jFoster426/Capstone/Invoices/README.txt

CA21G062DACII.pdf
Amazon
- Copper Shielding Foil
Total: $27.32

87327651.pdf
Digi-Key
- Parts for PoC
Total: $135.08

88081512.pdf
Digi-Key
- Parts for Main Board Prototype 1
Total: $209.14

88237087.pdf
Digi-Key
- Microcontrollers (ESP32S3 and DevKit)
- Load Cell Amplifier
Total: $76.77

88622169.pdf
Digi-Key
- Load Cells
Total: $56.75

89655280.pdf
Digi-Key
- Shin Strap Prototype 1 Parts
- Omit: SFURS Components, Ritesh's Components
        4.87 + 0.45 + 7.79 + 3.32 + 12.95 + 2.59 + 2.59 + 0.46 + 0.22
      + 0.54 + 6.43 + 0.22 + 0.18 + 0.40 + 0.22 + 0.37 + 0.54 + 0.54
      + 4.27 + 39.53 + 1.09 + 2.46 + 1.35 + 3.36 + 6.99 + 3.30
- Omit Total: $107.03
Total: 218.33 - (107.03 * 1.12) = $98.46

90552447.pdf
Digi-Key
- Main Board Parts
Total: $197.43

2039395A202203161013858.pdf
JLCPCB
- Main Board PCB Prototype 1
Total: $35.89
Total Charged to Credit Card: $37.11

2039395A202206251404717.pdf
JLCPCB
- Main Board PCB Prototype 2
Total: $76.41
Total Charged to Credit Card: $78.54

2039395A202206271223129.pdf
JLCPCB
- LCD PCB
- Load Cell PCB
- Omit: Ritesh's PCB ($5.19)
Total: 40.97 - 5.19 = $35.78
Total Charged to Credit Card: 42.11 - (5.19 * 1.0278) = $36.78

2039395A202205171115238.pdf
JLCPCB
- Shin Strap PCB Prototype 1
Total: $34.40
Total Charged to Credit Card: $35.67

------------------ Total ------------------

27.32 + 135.08 + 209.14 + 76.77 + 56.75 + 98.46 + 197.43 + 37.11 + 78.54 + 36.78 + 35.67

= 989.05
