jFoster426/Capstone/Misc/ISCP Pinout Beta Boards.docx

Main Board

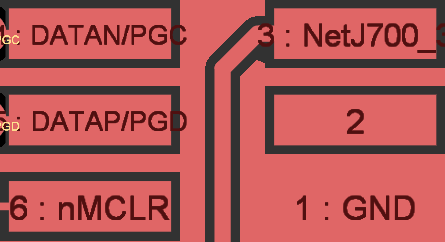
[picture p1: figure]

Shin Strap

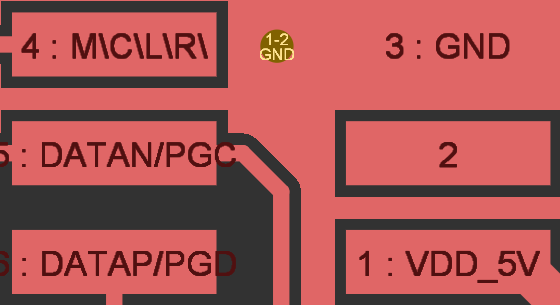
[picture p2: figure]
