jFoster426/Capstone/Lunch and Learn Presentations/Presentation1.pptx

STRASTech
Electronics Overview
Proof-of-Concept Prototype

## Slide 2

Electronics

Host Computer

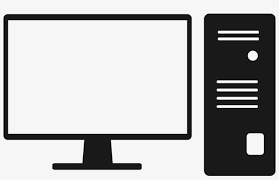
[picture p3: figure]
Free Pc Clipart, Download Free Pc Clipart png images, Free ClipArts on Clipart Library
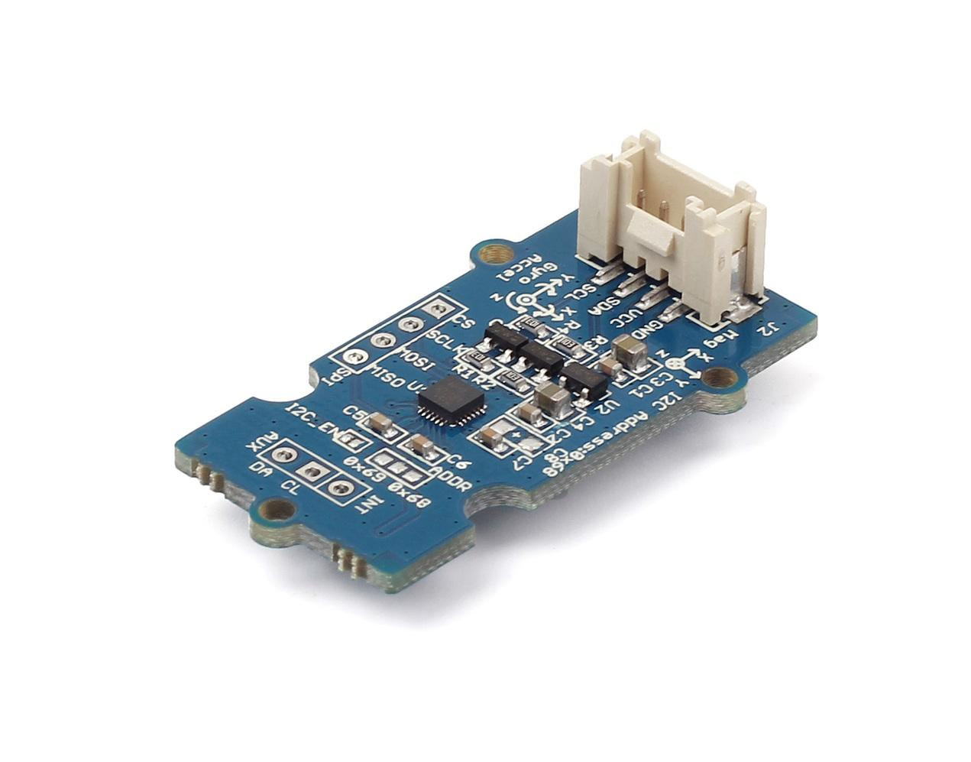
[picture p4: figure]
Grove - IMU 9DOF v2.0 - Seeed Wiki

9 Axis IMU (x2)

Start/Stop LED

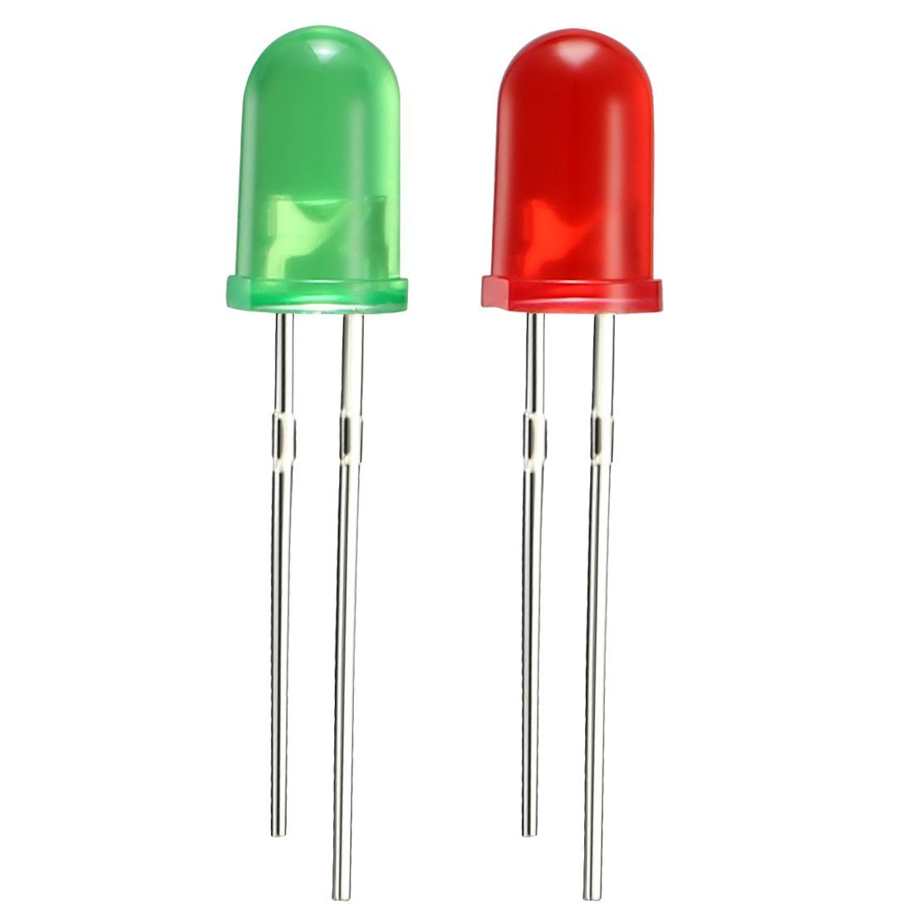
[picture p5: figure]
uxcell 16pcs 2 Colors x 8pcs 5mm Red Green LED Diode Lights Colored Lens Diffused Round 20mA Lighting Bulb Lamp Electronic Components Light Emitting Diodes: Amazon.com: Industrial & Scientific
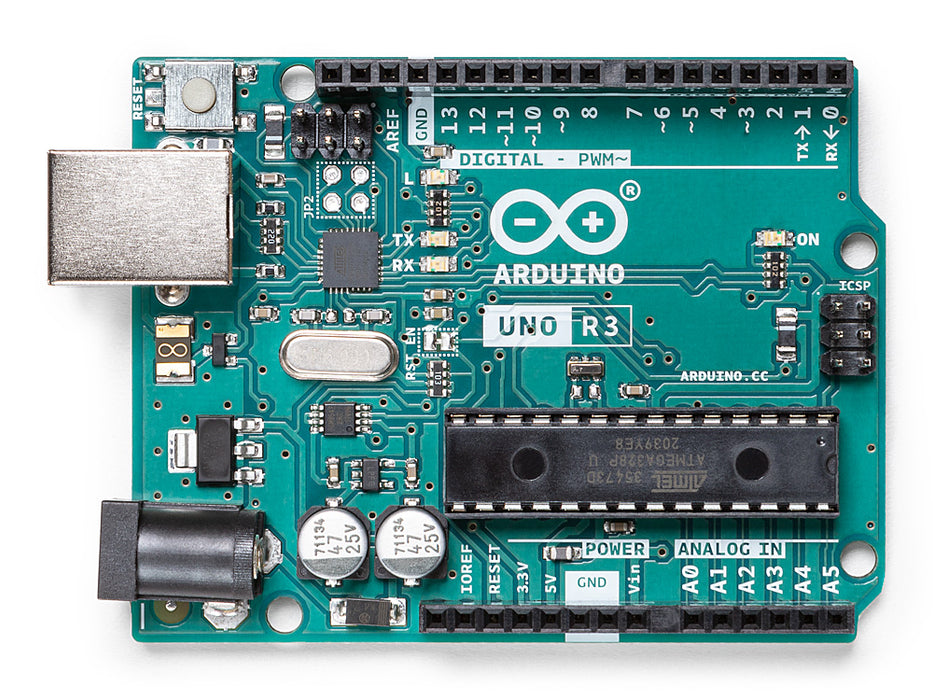
[picture p6: figure]
Arduino Uno Rev3 — Arduino Official Store

Arduino UNO

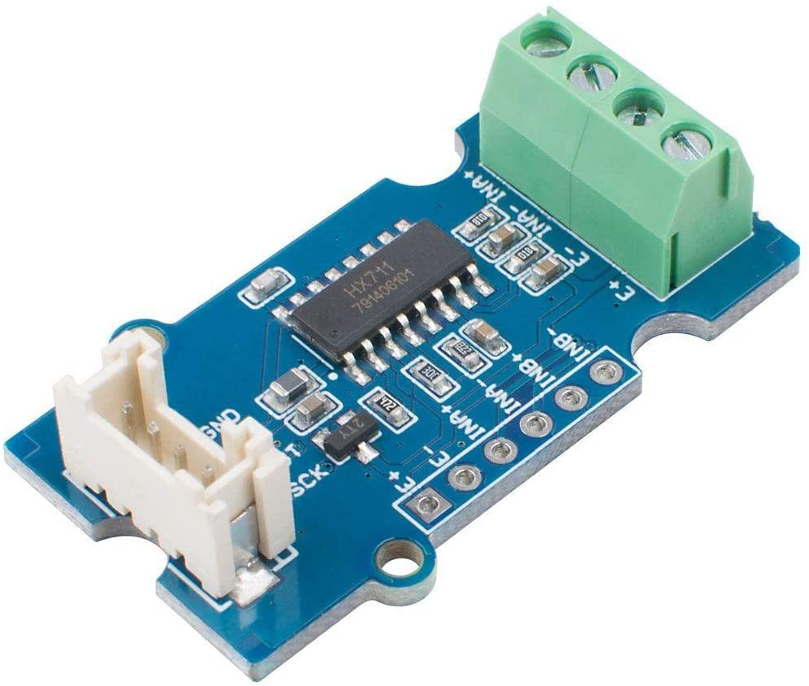
[picture p7: figure]
Seeed Grove - ADC for Load Cell: Amazon.de: Computer & Accessories

HX711 Load Cell Amp

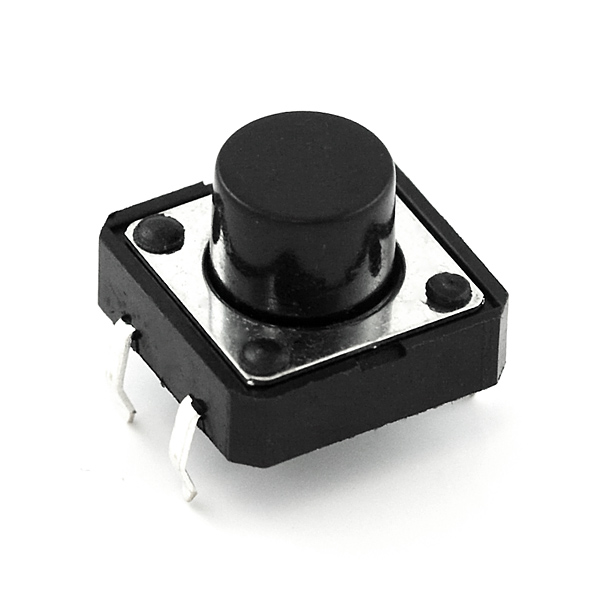
[picture p8: figure]
Momentary Pushbutton Switch - 12mm Square - COM-09190 - SparkFun Electronics

Start/Stop Button

## Slide 3

Electronics – Load Cell

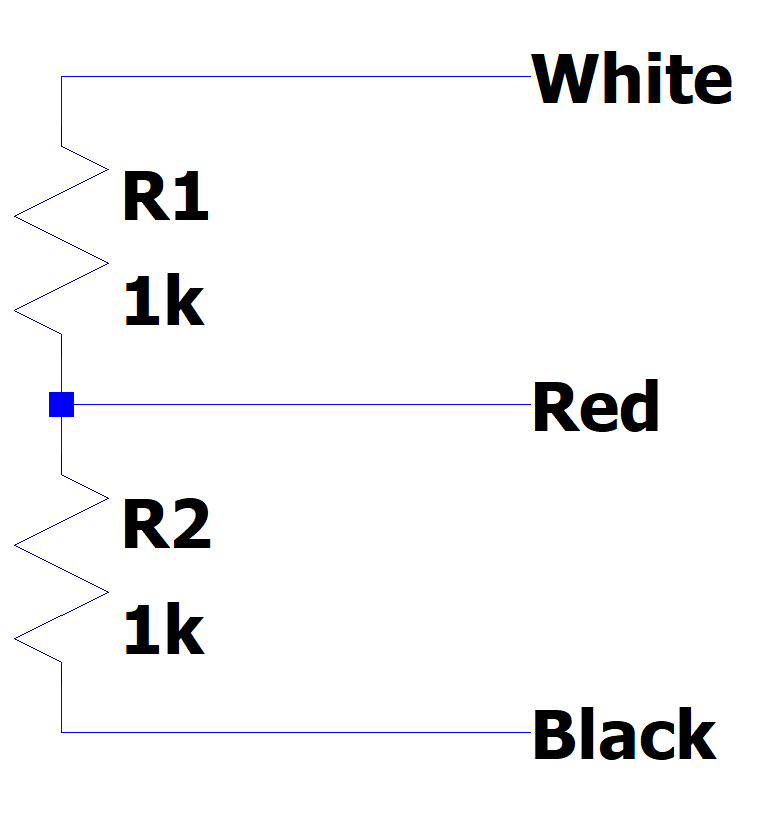
[picture p9: figure]

## Slide 4

Electronics – Load Cell Bridge

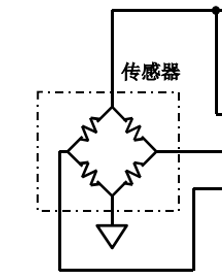
[picture p10: figure]

Load Cell #1

Load Cell #2

5V

Load Cell Amplifier

## Slide 5

Electronics – HX711

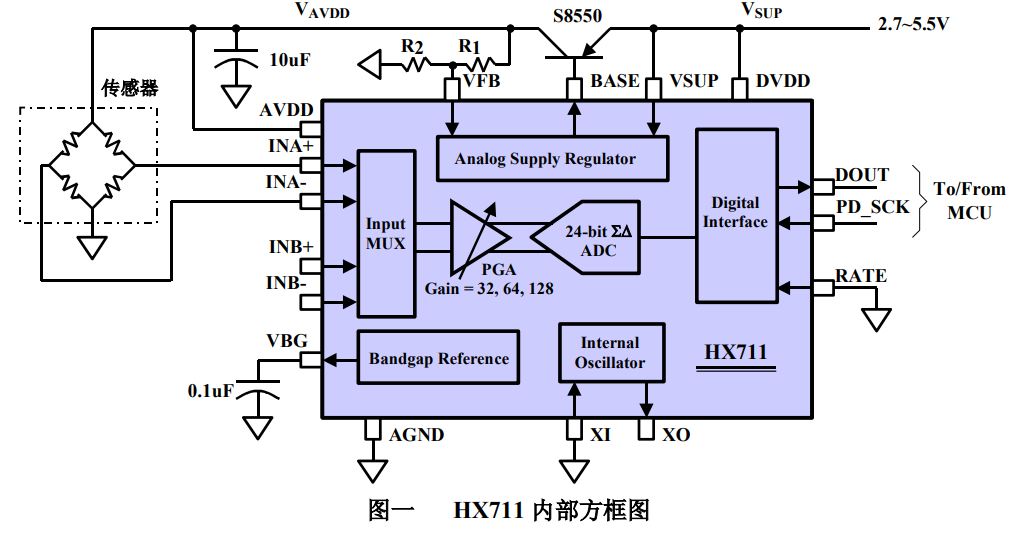
[picture p11: figure]

RATE=1, 80 Samples/s
RATE=0, 10 Samples/s

## Slide 6

Communicate to Arduino over I2C, allows both shin and foot IMU to use the same bus, with different addresses.

Electronics – IMU

Accelerometer

- Measure acceleration due to gravity when stationary
- Measure translational acceleration during motion
- How can we differentiate the two?

Gyroscope

- Measure angular (not translational) velocity
- Suffers from drift (reading a constant value even when still)

Arduino

SCL

SDA

Foot IMU

Shin IMU

Other Stuff (Future)

## Slide 7

Electronics – Firmware

Entry

Init Foot/Shin IMU

Red LED On

Button Pressed?

Green LED On

Button Pressed?

Get one frame of data, send to PC

## Slide 8

Electronics – Data Format

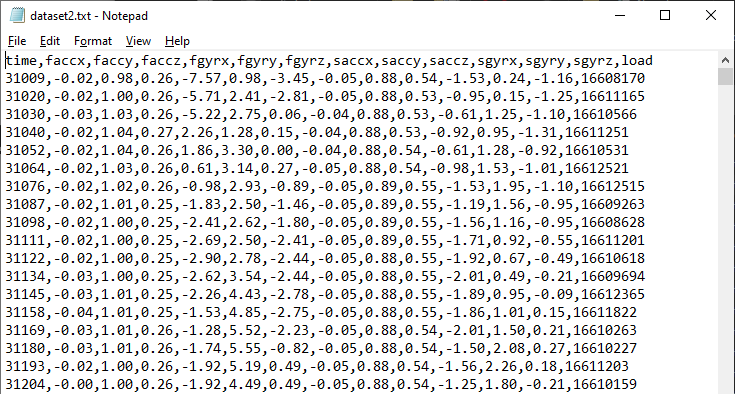
[picture p12: figure]

## Slide 9

Software – Overview

STRASAnkle.exe

Serial Port to .CSV

Filename.txt

Dataset_yyyy_mm_dd_hh_mm_ss.txt

MATLAB

USB

#1

#2

## Slide 10

Software – Joint Angle Algorithm

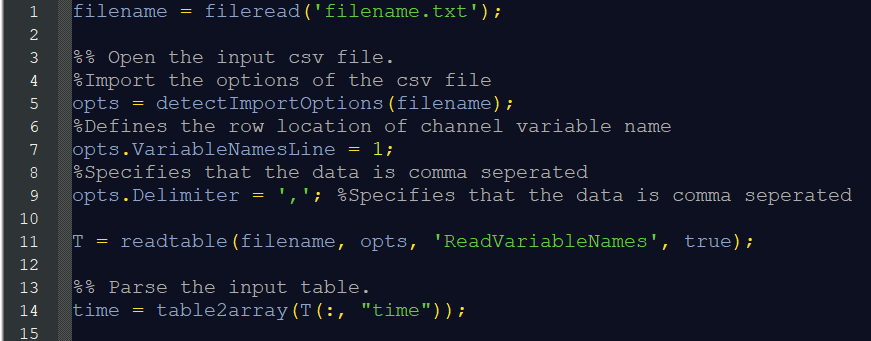
[picture p13: figure]

## Slide 11

Software – Joint Angle Algorithm

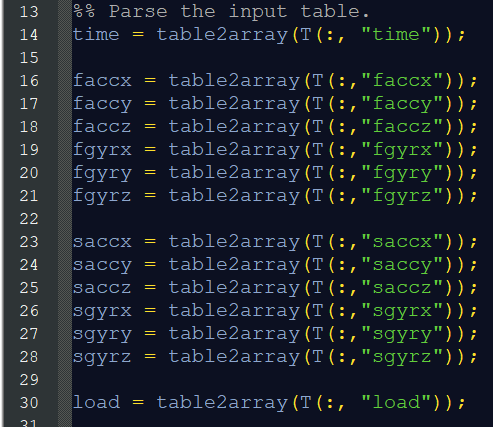
[picture p14: figure]

## Slide 12

Software – Joint Angle Algorithm

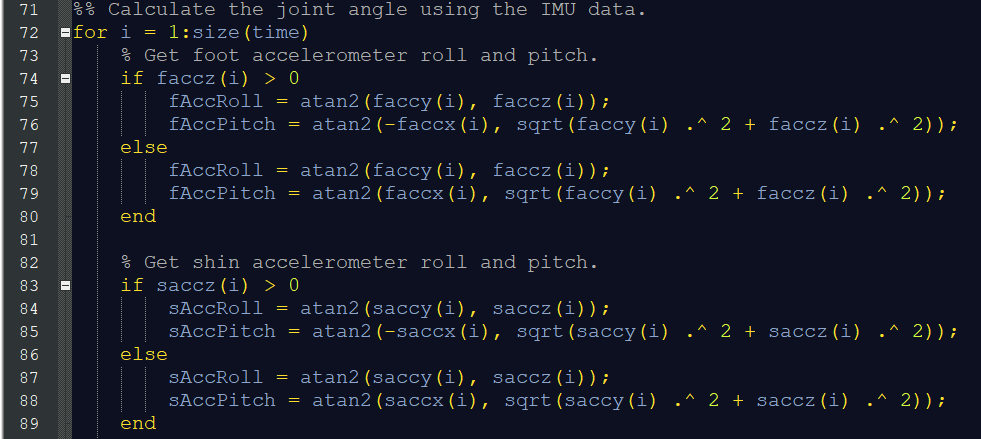
[picture p15: figure]

## Slide 13

Software – Joint Angle Algorithm

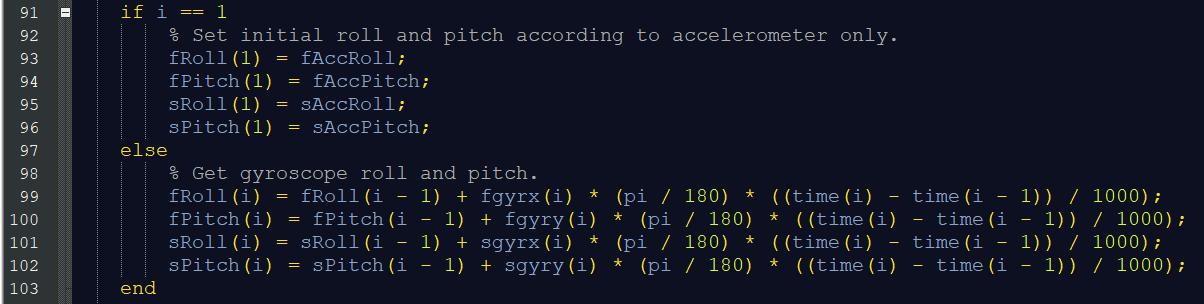
[picture p16: figure]

## Slide 14

Software – Joint Angle Algorithm

## Slide 15

Software – Angular Velocity Algorithm
