jFoster426/Capstone/Caterpillar/Solid Models/Magnet and Dowel 1.SLDASM

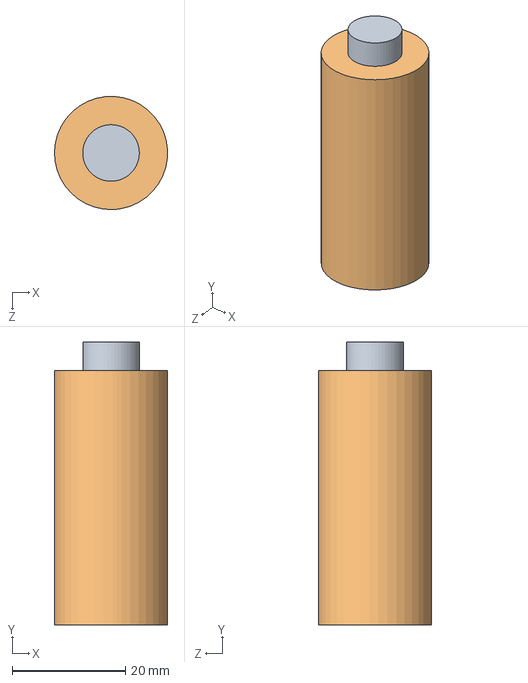
[picture p17: CAD file, 2022-11-08]
Caterpillar/Solid Models/Magnet and Dowel 1.SLDASM
20.0 x 50.0 x 20.0 mm
Magnet 1
Dowel 1
