jFoster426/Capstone/Caterpillar/Solid Models/Assem1.STEP

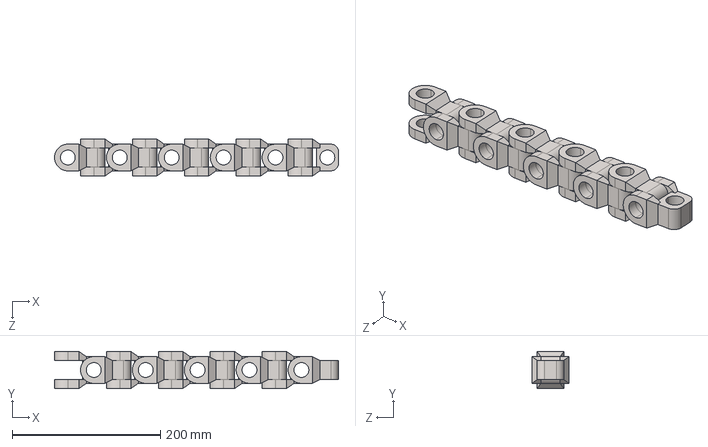
[picture p18: CAD file, 2022-11-08]
Caterpillar/Solid Models/Assem1.STEP
383.0 x 50.0 x 50.0 mm
Joint 1 x 10
