jFoster426/Capstone/Caterpillar/Solid Models/Dowel 1.SLDPRT

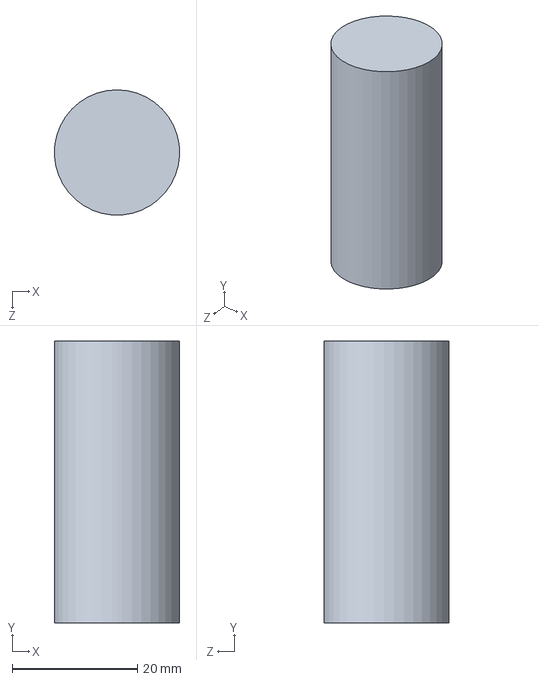
[picture p19: CAD file, 2022-11-08]
Caterpillar/Solid Models/Dowel 1.SLDPRT
20.0 x 45.0 x 20.0 mm
