jFoster426/Capstone/Caterpillar/Solid Models/PCB 1.SLDPRT

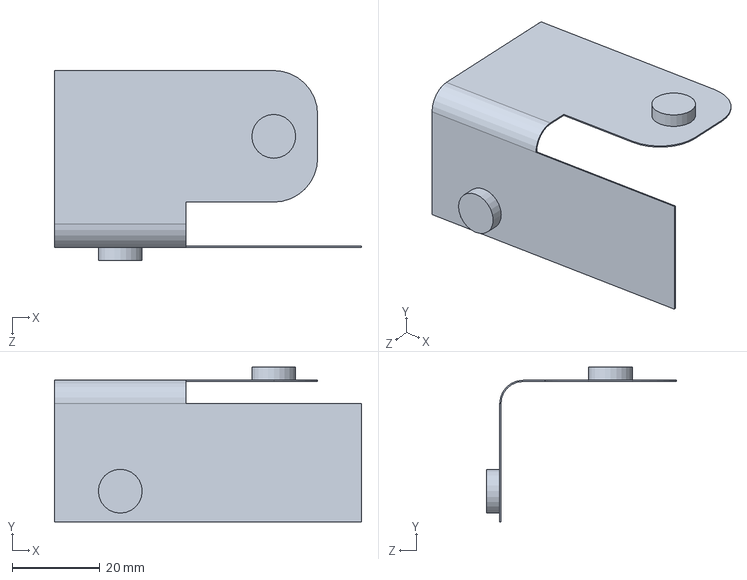
[picture p20: CAD file, 2022-11-08]
Caterpillar/Solid Models/PCB 1.SLDPRT
70.0 x 35.3 x 43.3 mm
