jFoster426/Capstone/Caterpillar/Solid Models/Magnet 1.SLDPRT

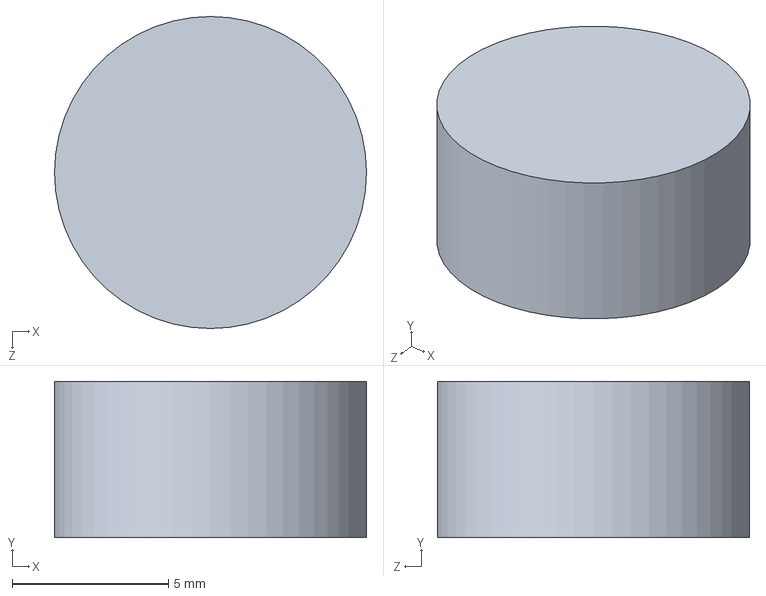
[picture p21: CAD file, 2022-11-08]
Caterpillar/Solid Models/Magnet 1.SLDPRT
10.0 x 5.00 x 10.0 mm
