jFoster426/Capstone/Caterpillar/Solid Models/Joint 1.SLDPRT

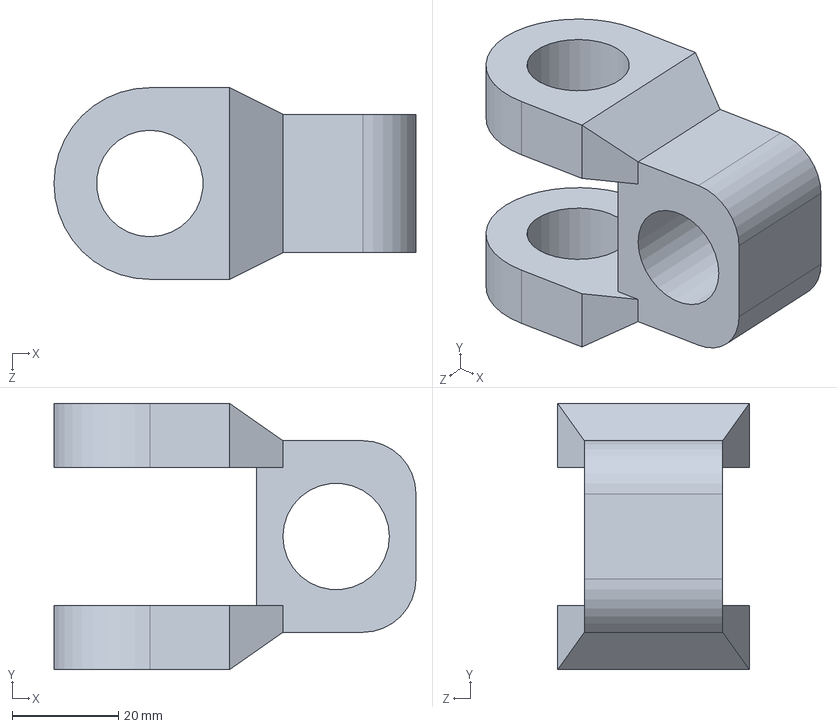
[picture p22: CAD file, 2022-11-08]
Caterpillar/Solid Models/Joint 1.SLDPRT
68.0 x 50.0 x 36.0 mm
