jFoster426/Capstone/(list of files, cad)

Other CAD files:
Caterpillar/Solid Models/Assem1.SLDASM
