jFoster426/Capstone/Misc/Main Board Rough Schematic.pdf

# Inertial Measurement and RTC

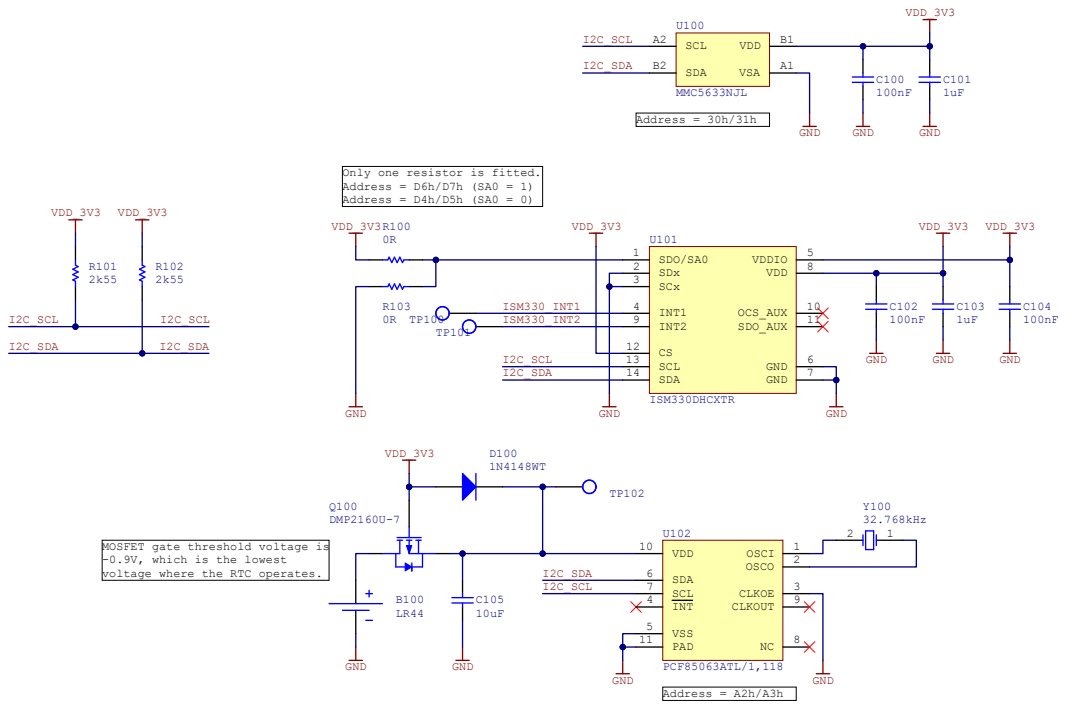
[picture p23: page 1]

Only one resistor is fitted.
Address = D6h/D7h (SA0 = 1)
Address = D4h/D5h (SA0 = 0)

MOSFET gate threshold voltage is
-0.9V, which is the lowest
voltage where the RTC operates.

# Load Cell Acquisition

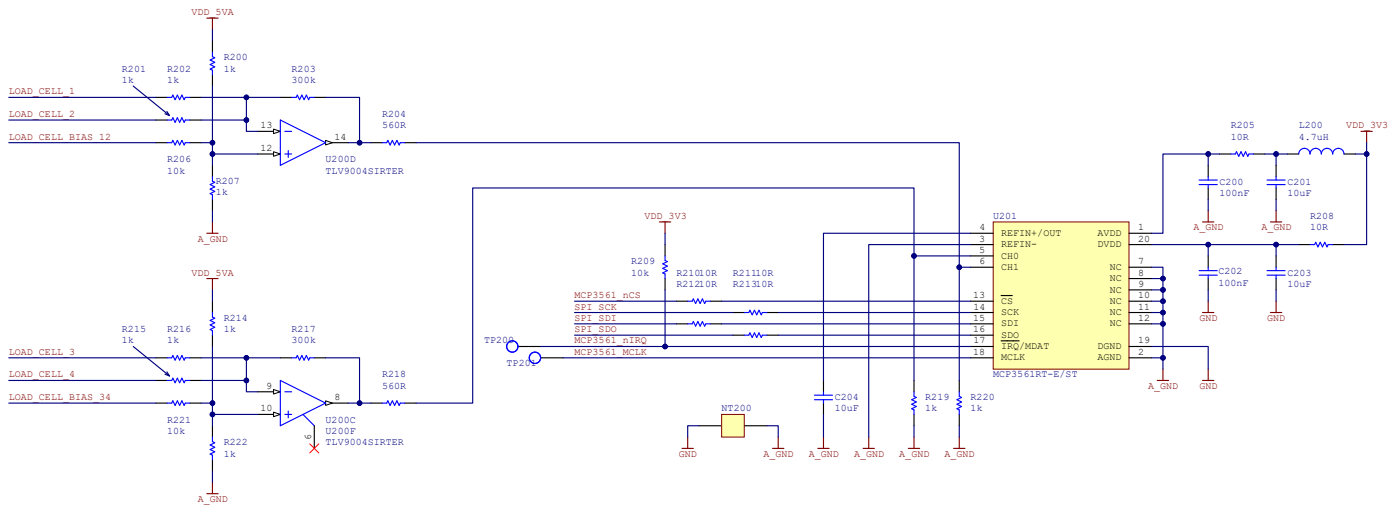
[picture p24: page 2]

# Load Cell Biasing

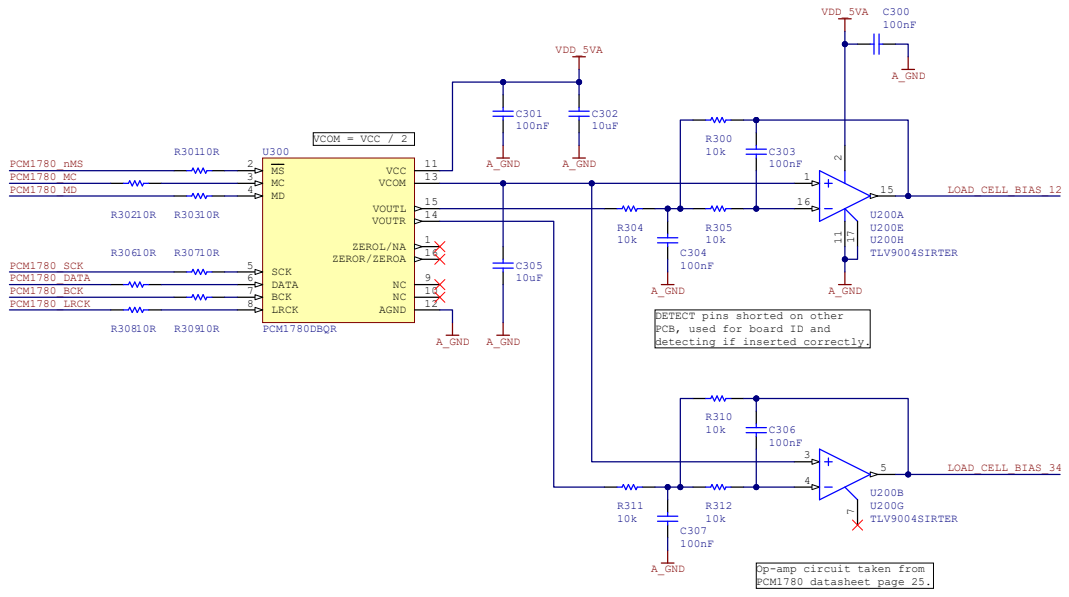
[picture p25: page 3]

DETECT pins shorted on other
PCB, used for board ID and
detecting if inserted correctly.

Op-amp circuit taken from
PCM1780 datasheet page 25.

# Peripherals (Main Board)

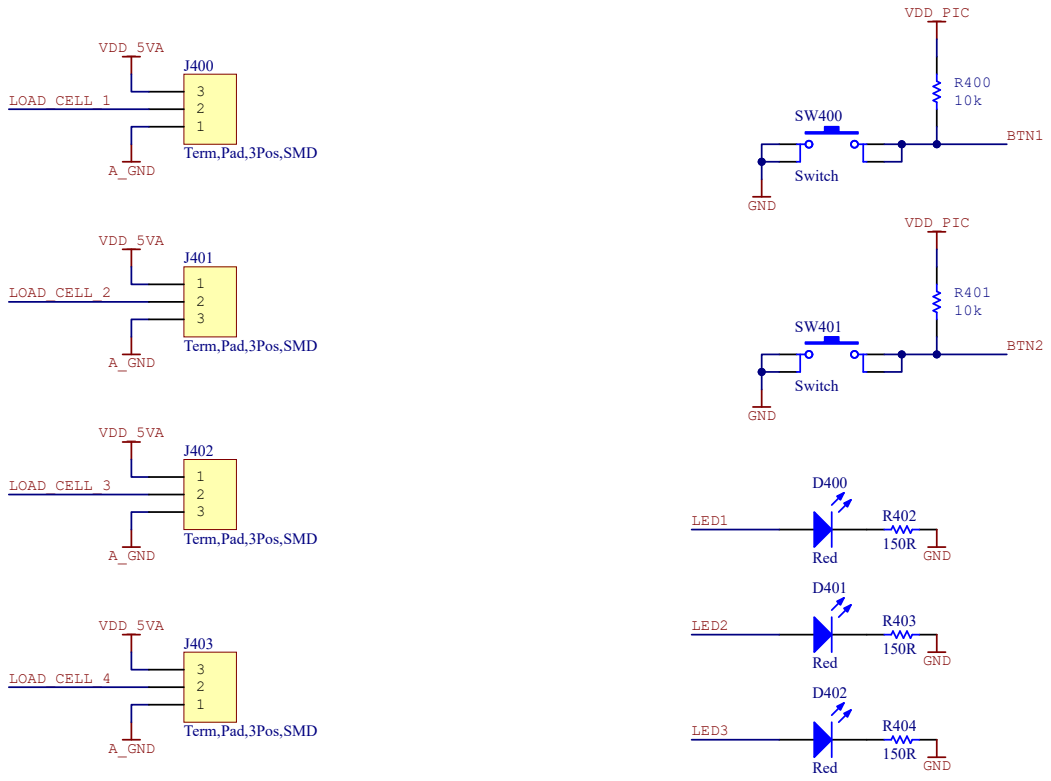
[picture p26: page 4]

# ESP32 / Flash

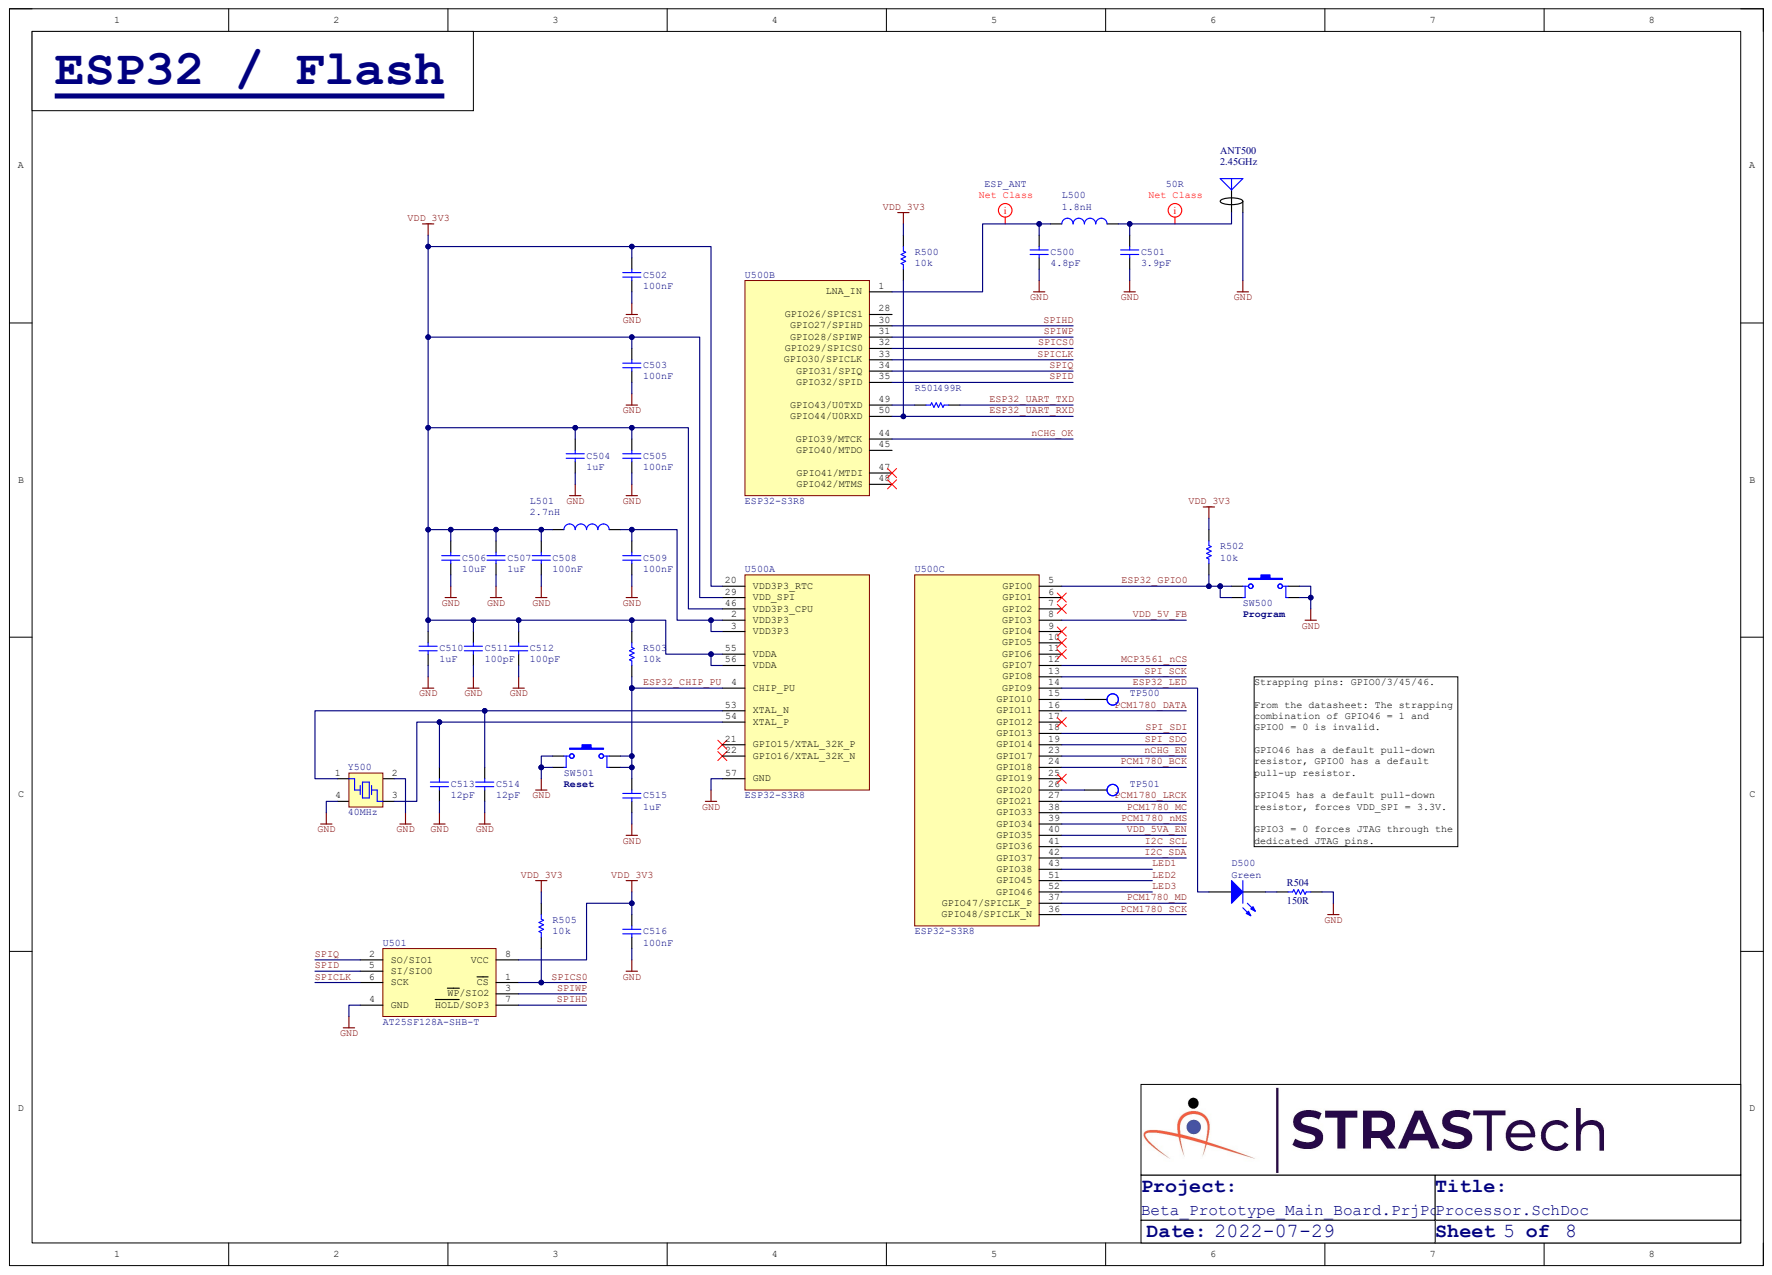
[picture p27: page 5]

From the datasheet: The strapping
combination of GPIO46 = 1 and
GPIO0 = 0 is invalid.

GPIO46 has a default pull-down
resistor, GPIO0 has a default
pull-up resistor.

GPIO45 has a default pull-down
resistor, forces VDD_SPI = 3.3V.

GPIO3 = 0 forces JTAG through the
dedicated JTAG pins.

# Regulation and Charging

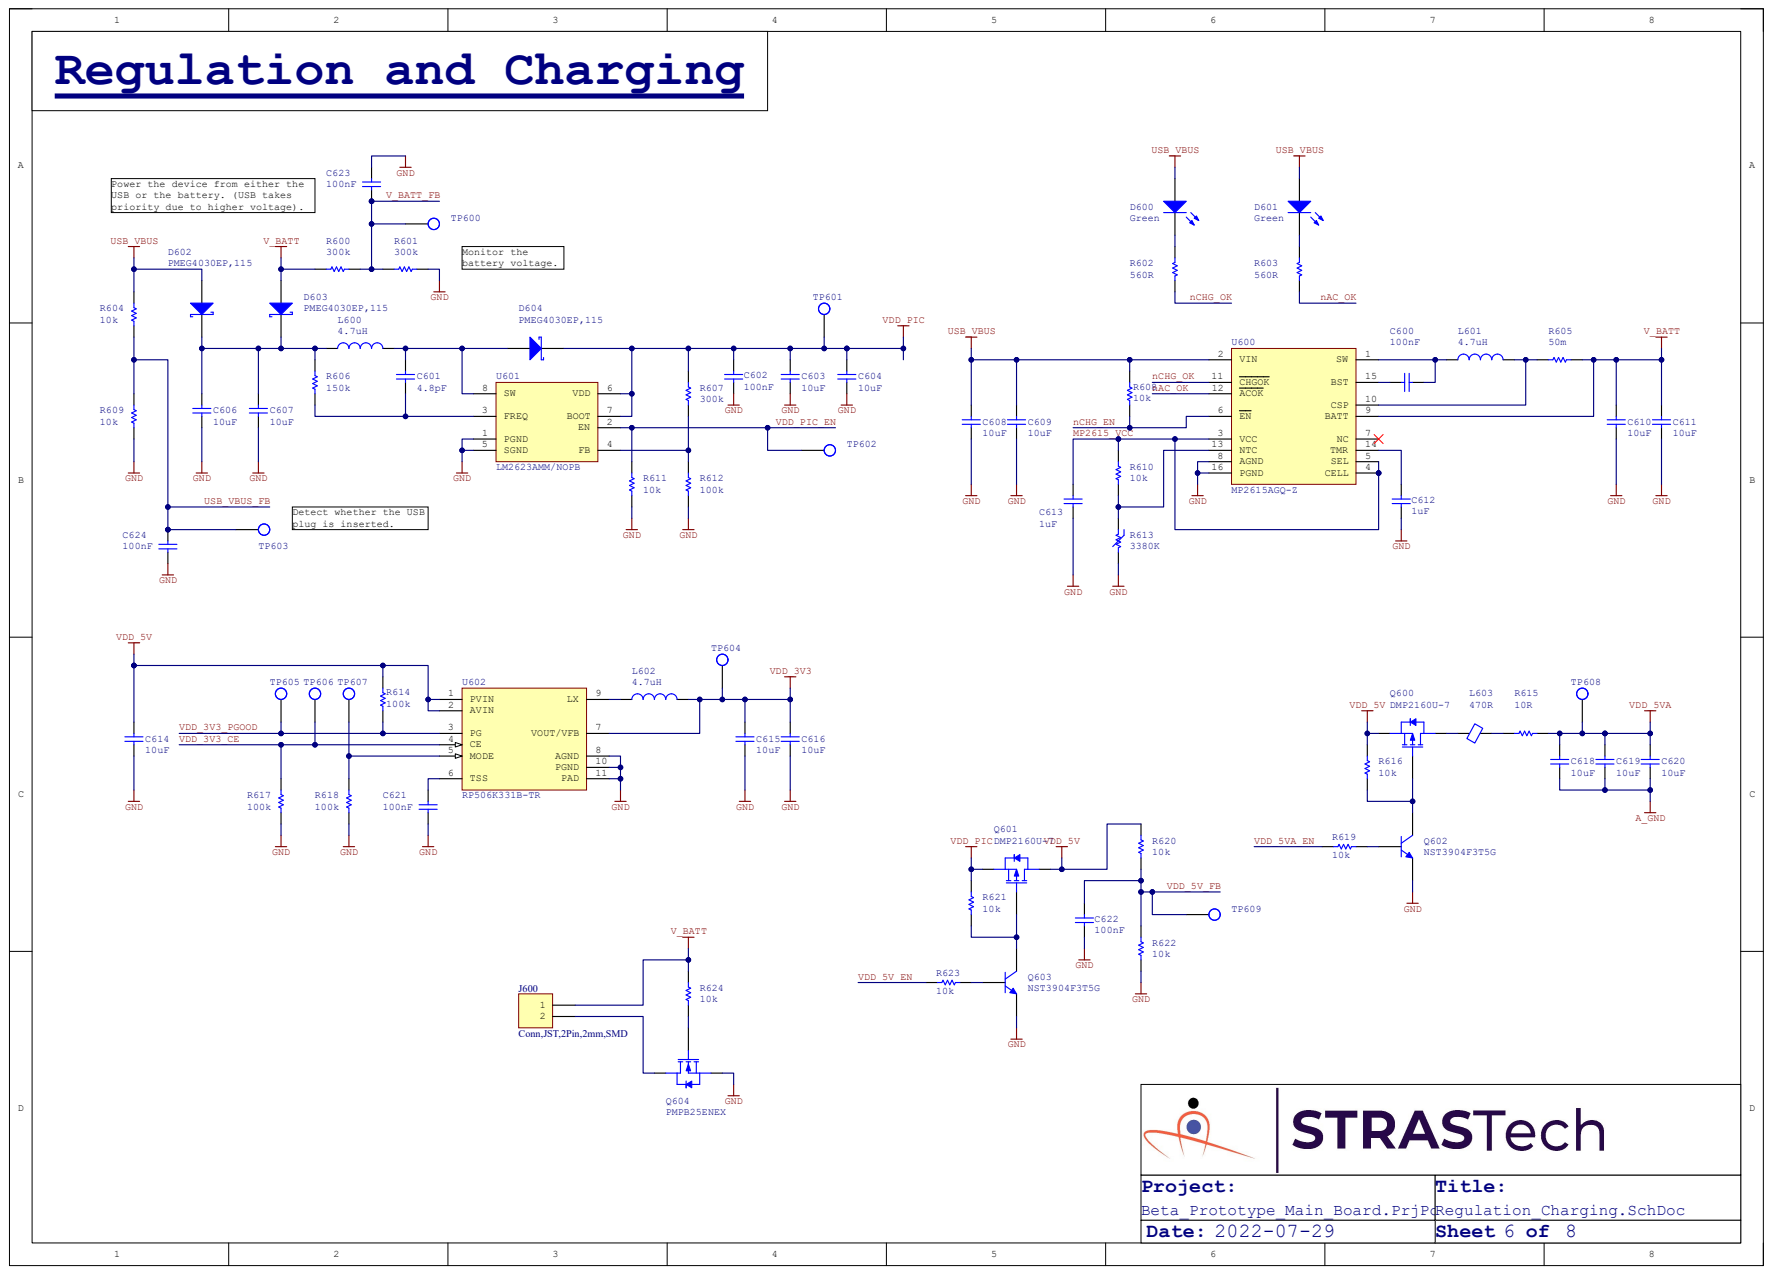
[picture p28: page 6]

Power the device from either the
USB or the battery. (USB takes
priority due to higher voltage).

Detect whether the USB
plug is inserted.

# Shin Strap Interface

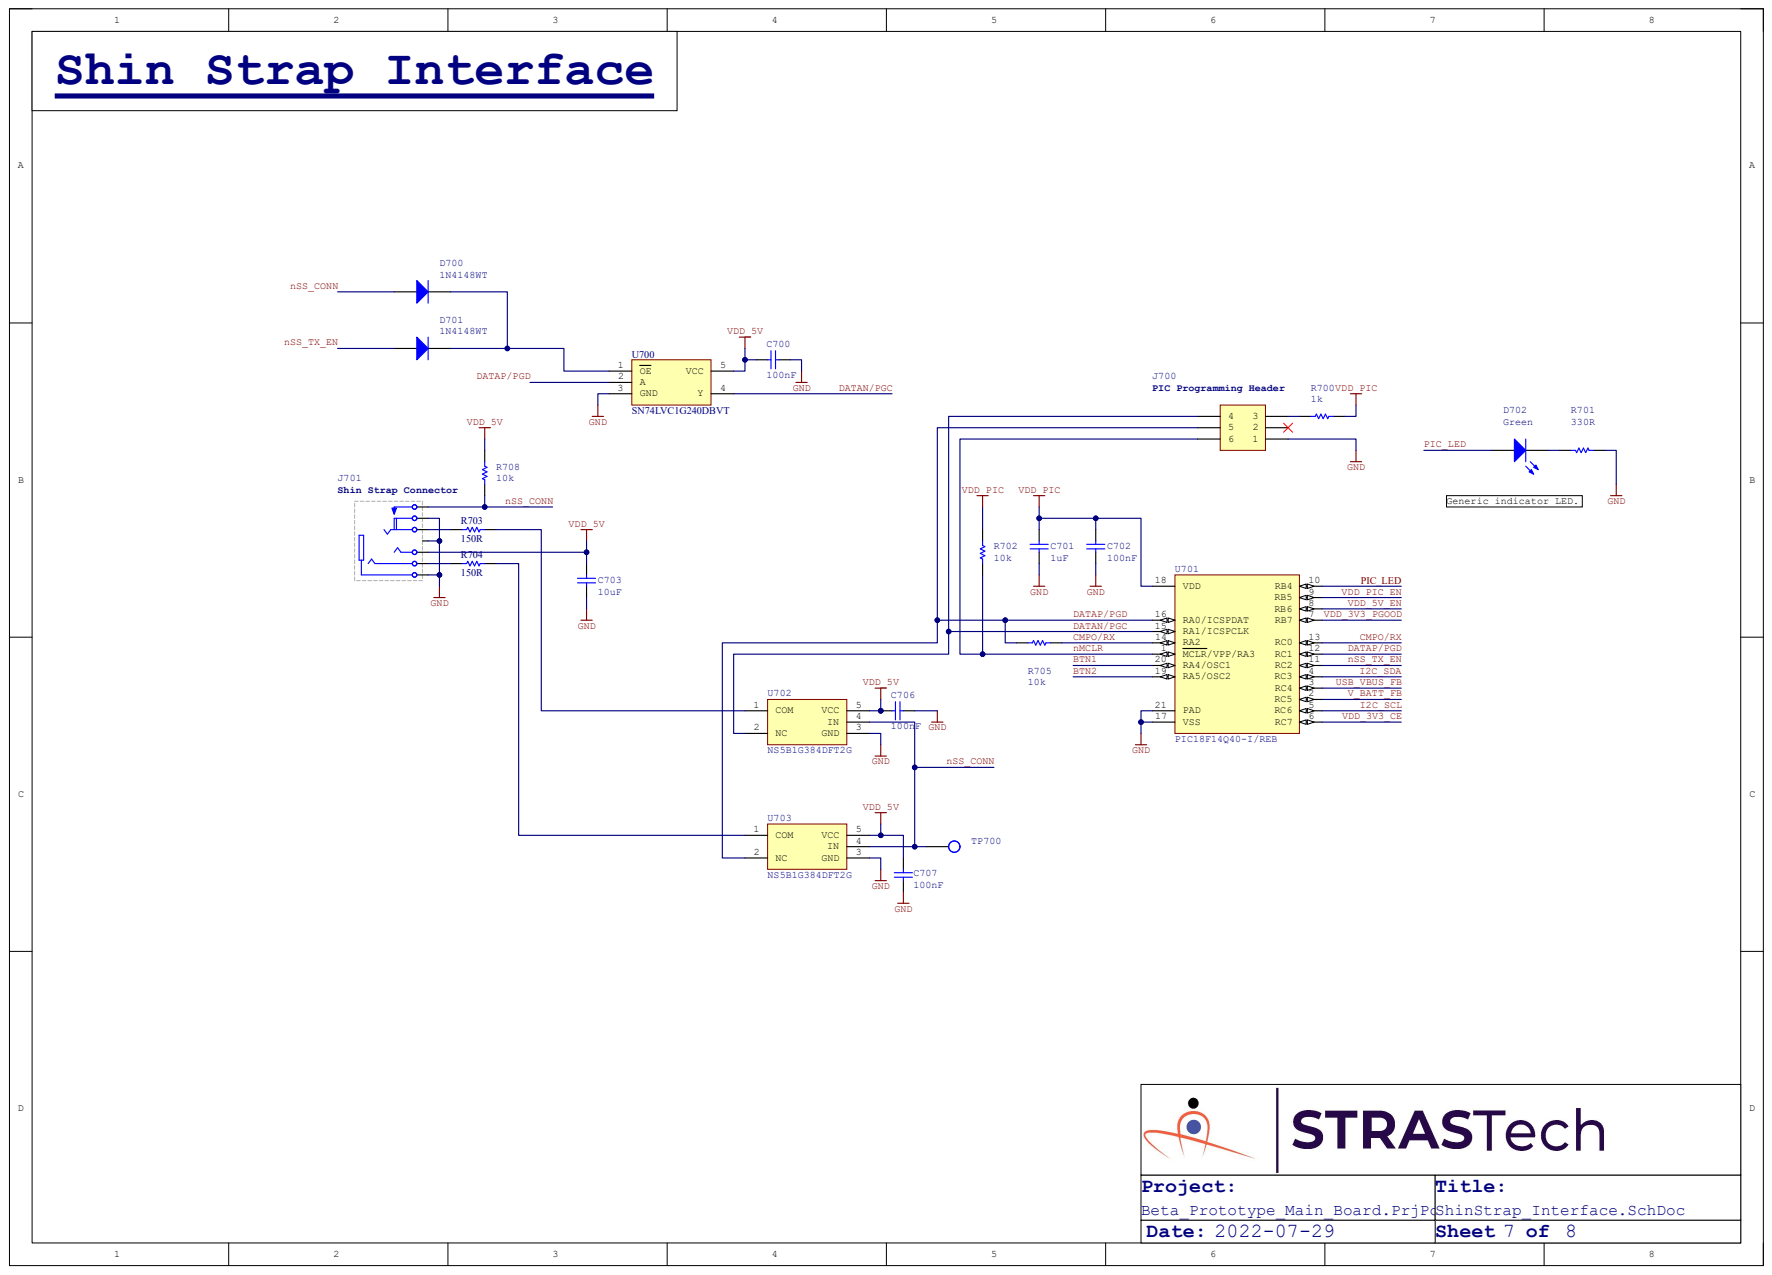
[picture p29: page 7]

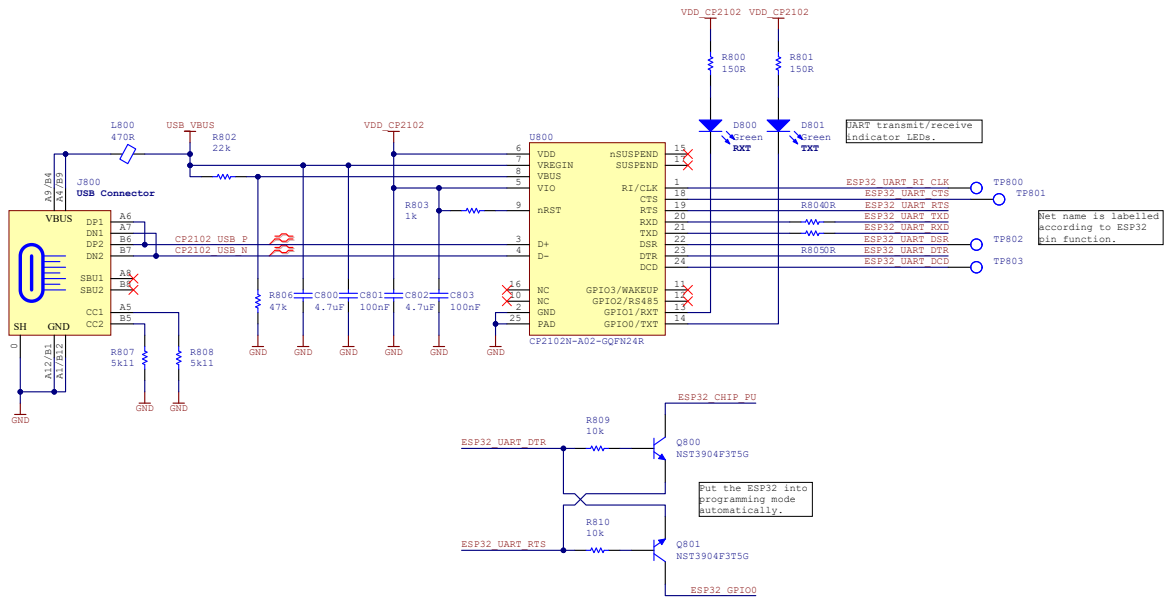
[picture p30: page 8]

Net name is labelled
according to ESP32
pin function.
