jFoster426/Capstone/Misc/Shin Strap Rough Schematic.pdf

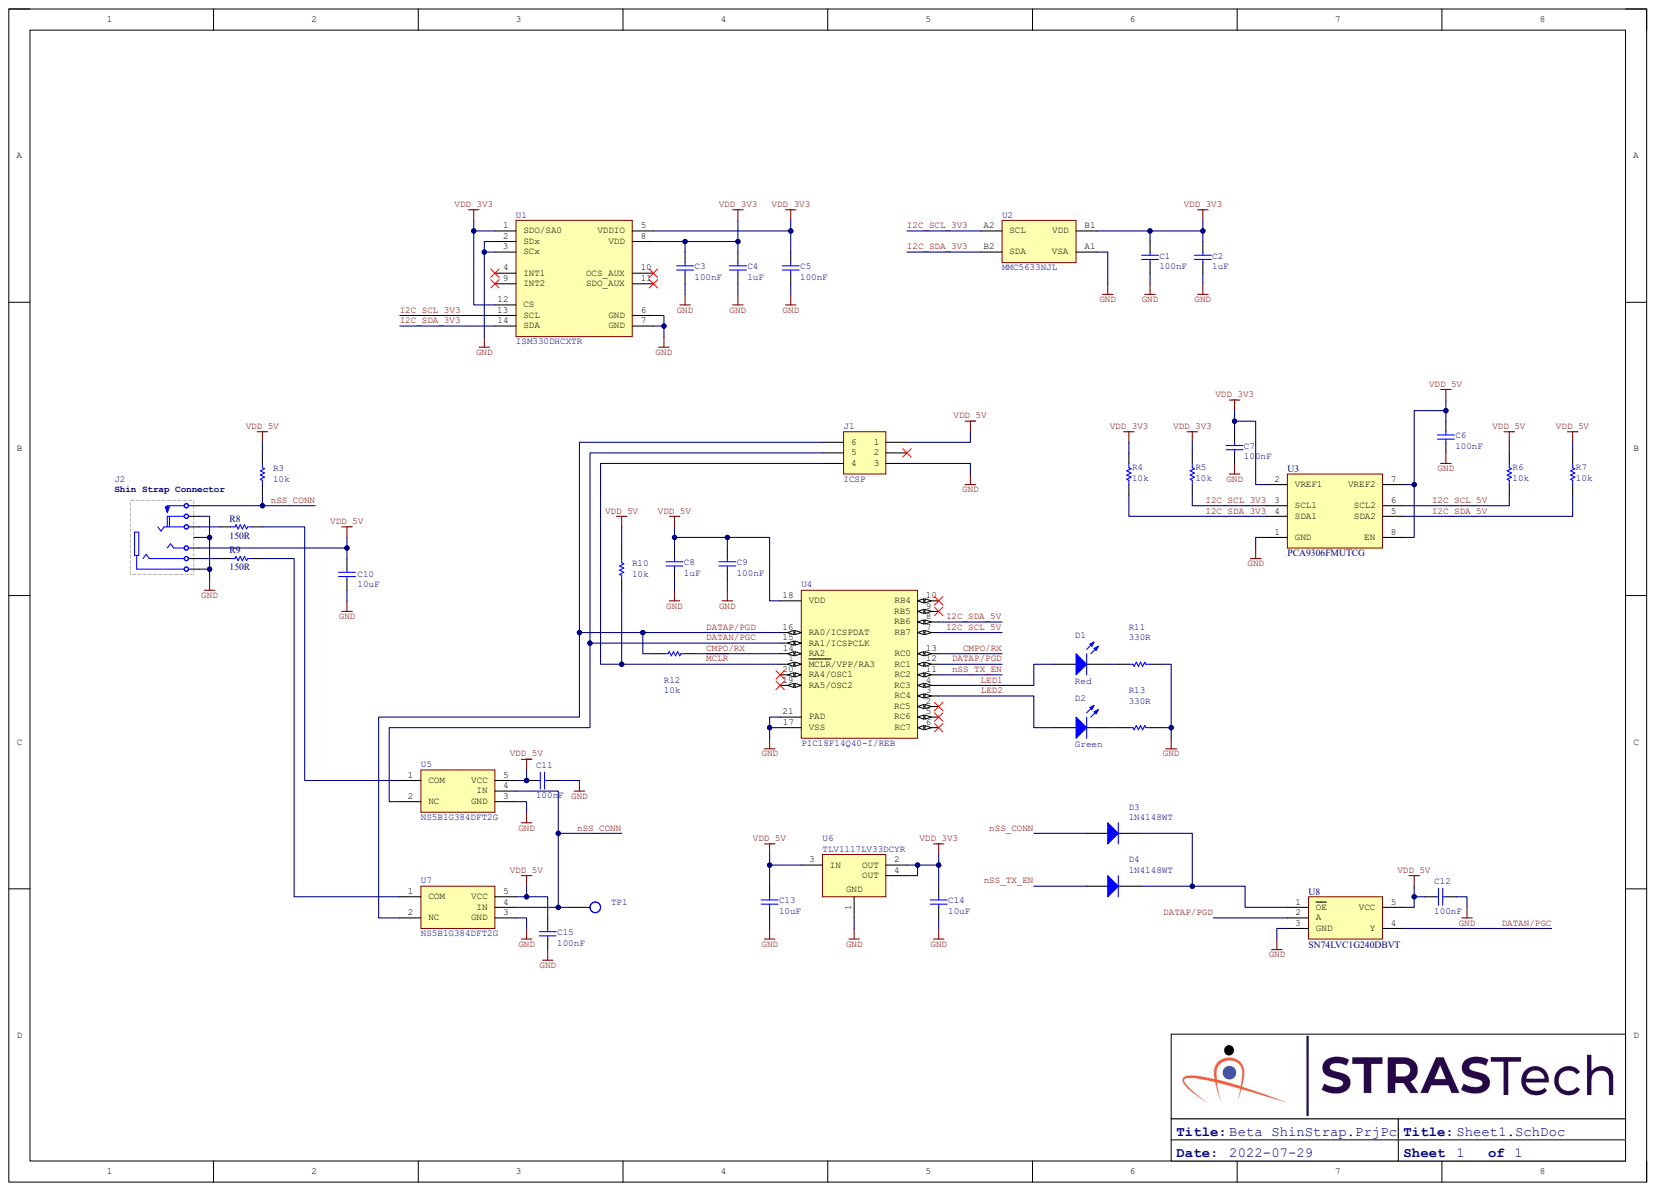
[picture p31: page 1]
