jFoster426/Capstone/(list of files, drawings)

Other design files:
Beta_Prototype/Beta_Prototype_Main_Board.PrjPcb
Beta_Prototype/Inertial_Measurement_RTC.SchDoc
Beta_Prototype/Load_Cell_Acquisition.SchDoc
Beta_Prototype/Load_Cell_Biasing.SchDoc
Beta_Prototype/Peripherals_Main_Board.SchDoc
Beta_Prototype/Processor.SchDoc
Beta_Prototype/Regulation_Charging.SchDoc
Beta_Prototype/ShinStrap_Interface.SchDoc
Beta_Prototype/USB_Serial.SchDoc
Beta_ShinStrap/Beta_ShinStrap.PrjPcb
Beta_ShinStrap/PCB1.PcbDoc
Beta_ShinStrap/Sheet1.SchDoc
Prototype_1/PCB1.PcbDoc
Prototype_1/Prototype_1.PrjPcb
Prototype_1/Sheet1.SchDoc
Prototype_1/Sheet2.SchDoc
Prototype_1/Sheet3.SchDoc
Prototype_1/Sheet4.SchDoc
Prototype_1/Sheet5.SchDoc
Prototype_1/Sheet6.SchDoc
Prototype_2/Prototype_2_LCD_Board/LCD_Board.PcbDoc
Prototype_2/Prototype_2_LCD_Board/Peripherals_LCD_Board.SchDoc
Prototype_2/Prototype_2_LCD_Board/Prototype_2_LCD_Board.PrjPcb
Prototype_2/Prototype_2_Load_Cell_Board/Load_Cell_Board.PcbDoc
Prototype_2/Prototype_2_Load_Cell_Board/Load_Cell_Board.SchDoc
Prototype_2/Prototype_2_Load_Cell_Board/Prototype_2_Load_Cell_Board.PrjPcb
Prototype_2/Prototype_2_Main_Board/Inertial_Measurement_RTC.SchDoc
Prototype_2/Prototype_2_Main_Board/Load_Cell_Acquisition.SchDoc
Prototype_2/Prototype_2_Main_Board/Load_Cell_Biasing.SchDoc
Prototype_2/Prototype_2_Main_Board/Peripherals_Main_Board.SchDoc
Prototype_2/Prototype_2_Main_Board/Processor.SchDoc
Prototype_2/Prototype_2_Main_Board/Prototype_2_Main_Board.PrjPcb
Prototype_2/Prototype_2_Main_Board/Regulation_Charging.SchDoc
Prototype_2/Prototype_2_Main_Board/ShinStrap_Interface.SchDoc
Prototype_2/Prototype_2_Main_Board/USB_Serial.SchDoc
Schlib1.SchLib
ShinStrap_V1/ShinStrap_V1.PrjPcb
