jFoster426/Capstone/Firmware_ESP32/alpha1_bak/components/adc_st/include/adc_st.h

#ifndef adc_st_h
#define adc_st_h

#include <stdio.h>
#include <stdlib.h>
#include <stdint.h>
#include <string.h>
#include "freertos/FreeRTOS.h"
#include "freertos/task.h"
#include "driver/spi_master.h"
#include "driver/gpio.h"

#include "sdkconfig.h"
#include "esp_log.h"

// These pins define the IO pins used for the SPI bus.
// CS pin is uniquely defined for each function.
#define SPI_PIN_NUM_MISO (14)
#define SPI_PIN_NUM_MOSI (13)
#define SPI_PIN_NUM_CLK  (8)

void spi_transfer(spi_device_handle_t *adc, const uint8_t *tx_data, uint8_t *rx_data, const uint8_t data_len);

void adc_init(spi_device_handle_t *adc, uint8_t cs_pin);

void adc_read_raw(spi_device_handle_t *adc, uint32_t *ch0, uint32_t *ch1);

void adc_read_voltage(spi_device_handle_t *adc, double *ch0v, double *ch1v);

#endif
