jFoster426/Capstone/(commit log)

2022-03-03 worked on schematic
    [Prototype_1.PrjPcb, Sheet1.SchDoc, Sheet2.SchDoc, Sheet3.SchDoc, Sheet4.SchDoc, Sheet5.SchDoc, Sheet6.SchDoc]
2022-03-04 assigned all footprints, annotated
    [PCB1.PcbDoc, Prototype_1.PrjPcb, Sheet1.SchDoc, Sheet2.SchDoc, Sheet3.SchDoc, Sheet4.SchDoc, Sheet5.SchDoc, Sheet6.SchDoc]
2022-03-10 updated schematics
    [PCB1.PcbDoc, Prototype_1.PrjPcb, Sheet1.SchDoc, Sheet2.SchDoc, Sheet3.SchDoc, Sheet4.SchDoc, Sheet5.SchDoc, Sheet6.SchDoc]
2022-05-14 sync before working on revb electronics
    [PCB1_Copper_Signal_1.gbr, PCB1_Copper_Signal_2.gbr, PCB1_Copper_Signal_Bot.gbr, PCB1_Copper_Signal_Top.gbr, PCB1_Legend_Bot.gbr, PCB1_Legend_Top.gbr, PCB1_NPTH_Drill.gbr, PCB1_PTH_Drill.gbr]
2022-05-17 shin strap v1 addition
    [PCB1.PcbDoc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]
2022-05-18 adding all matlab, arduino and esp code
    [partitions_example.csv]
2022-05-24 worked on alpha0 firmware
    [partitions_example.csv]
2022-06-02 working on prototype 2
    [1_Processor.SchDoc, 2_USB_Serial.SchDoc, 3_Load_Cell_Biasing.SchDoc, 4_Load_Cell_Acquisition.SchDoc, 5_Inertial_Measurement_RTC.SchDoc, 6_Peripherals.SchDoc, Main_Board.PcbDoc, Main_Board.step]
2022-06-07 added PIC code, 4 load cell arduino testing code
2022-06-11 reorganized prototype 2, created 3 board design
    [1_Processor.SchDoc, 2_USB_Serial.SchDoc, 3_Load_Cell_Biasing.SchDoc, 4_Load_Cell_Acquisition.SchDoc, 5_Inertial_Measurement_RTC.SchDoc, 6_Peripherals.SchDoc, Inertial_Measurement_RTC.SchDoc, Load_Cell_Acquisition.SchDoc]
2022-06-20 sync before going to school
    [Inertial_Measurement_RTC.SchDoc, Load_Cell_Acquisition.SchDoc, Load_Cell_Biasing.SchDoc, Peripherals_Main_Board.SchDoc, Processor.SchDoc, Prototype_2_Main_Board.PrjPcb, Regulation_Charging.SchDoc, ShinStrap_Interface.SchDoc]
2022-06-20 resync after school
    [LCD_Board.PcbDoc, Peripherals_LCD_Board.SchDoc, Processor.SchDoc, Prototype_2_LCD_Board.PrjPcb]
2022-06-24 fix some issues in shin strap
    [Load_Cell_Board.PcbDoc, Prototype_2_Main_Board.PrjPcb, ShinStrap_Interface.SchDoc]
2022-06-27 syncing after placing jlcpcb order for all three boards in prototype 2
    [Inertial_Measurement_RTC.SchDoc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]
2022-07-05 added pic gpio, esp32 gpio in hello world
2022-07-08 lvgl-captone-logo sync
    [code-format.cfg]
2022-07-12 added esp32s3r2 2MB ram
2022-07-13 display png with upng
    [code-format.cfg]
2022-07-19 beta prototype main pcb added
    [Beta_Prototype_Main_Board.PrjPcb, Inertial_Measurement_RTC.SchDoc, Load_Cell_Acquisition.SchDoc, Load_Cell_Biasing.SchDoc, Peripherals_Main_Board.SchDoc, Processor.SchDoc, Regulation_Charging.SchDoc, ShinStrap_Interface.SchDoc]
2022-07-20 coming back from school
    [Beta_ShinStrap.PrjPcb, PCB1.PcbDoc, Regulation_Charging.SchDoc, Sheet1.SchDoc, ShinStrap_Interface.SchDoc]
2022-07-21 worked on pic to esp32 connection, rtc, ism330
    [Beta_Prototype_Main_Board.PrjPcb, Beta_ShinStrap.PrjPcb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]
2022-09-25 add quaternion arduino code
2022-11-08 add aidan wrist code, update ankle code for start/stop button
    [Assem1.SLDASM, Assem1.STEP, Dowel 1.SLDPRT, Joint 1.SLDPRT, Magnet 1.SLDPRT, Magnet and Dowel 1.SLDASM, PCB 1.SLDPRT, Schlib1.SchLib]
